yrwid/SM/smBoard.sch

## KiCad design smBoard.sch (2019-12-15)

Schematic: smBoard.sch

Parts:
10uF: C2
16Mhz: Crystal
100nF: C3
C1: 100nF
C4, C5: 22nF
C6: 47uF
C7: 10uF
D1, D2: LED
J1, J3, J4, J5: 01x04
J2: USB_B_Micro
LS1: Speaker
Q1: BD137; TO-126-3_Vertical
R1: 10k
R2, R3: 1k
R4: 5k
R5: 430
R6: 2k
SW1, SW2, SW3, SW4: SW_Push
U1: LD1117S33TR_SOT223; SOT-223-3_TabPin2
U2: ATmega328P-PU; DIP-28_W7.62mm
