yrwid/SM/koncowe_na_pokaz.ino

#include <stdlib.h>
#include "Talkie.h"             //glosnik
#include "PinChangeInterrupt.h" //przerwania
#include "DHT.h"
#include <SoftwareSerial.h>   //esp8266 - komunikacja pomiedzy esp a atmega
#define INTERRUPT_PIN_T 10    //przyciski
#define INTERRUPT_PIN_H 11
#define INTERRUPT_PIN_P 12
#define INTERRUPT_PIN_C 13
#define DHT11_PIN 6           //pin czujnika DHT
#include <Wire.h>             //do czujnika bmp180 - tylko do komunikacji I2C
#include <Adafruit_BMP085.h>  //do bmp180 - odczytywanie wartosci
SoftwareSerial esp8266(2, 4); //rx, tx pins - esp jako klient atmegi
DHT dht;                      //inicjalizacja
String GET;                   //zmienna do get request (http protocol)

Adafruit_BMP085 bmp;		  //inicjalizacja bmp

String NazwaSieci = "AndroidAP8607"; //Tu podaj nazwe swojej sieci.
String HasloSieci = "eaed34aec159"; //Tu hasło do sieci.


/* talkie obiekt - inicjalizacja */

Talkie voice(true, false); //true - korzystamy z pinu 3(pwm), false - nie korzystamy z pinu 11 (odwrócony pwm)
boolean tell_T = false, tell_H = false, tell_C = false, tell_P = false; //do funkcji przerwan

/* inicjalizacja wymaiwanych słów */

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
const uint8_t spMINUS[]    PROGMEM = {0xE6, 0x28, 0xC4, 0xF8, 0x44, 0x9A, 0xFB, 0xCD, 0xAD, 0x8D, 0x2A, 0x4E, 0x4A, 0xBC, 0xB8, 0x8C, 0xB9, 0x8A, 0xA9, 0x48, 0xED, 0x72, 0x87, 0xD3, 0x74, 0x3B, 0x1A, 0xA9, 0x9D, 0x6F, 0xB3, 0xCA, 0x5E, 0x8C, 0xC3, 0x7B, 0xF2, 0xCE, 0x5A, 0x5E, 0x35, 0x66, 0x5A, 0x3A, 0xAE, 0x55, 0xEB, 0x9A, 0x57, 0x75, 0xA9, 0x29, 0x6B, 0xEE, 0xB6, 0xD5, 0x4D, 0x37, 0xEF, 0xB5, 0x5D, 0xC5, 0x95, 0x84, 0xE5, 0xA6, 0xFC, 0x30, 0xE0, 0x97, 0x0C, 0x0D, 0x58, 0x40, 0x03, 0x1C, 0xA0, 0xC0, 0xFF, 0x03};

/* liczba z przedzialu <-9999 , 9999> */
void sayNumber(long n) 
{
  if (n<0) 
  {
      voice.say(spMINUS);
      sayNumber(-n);
  } 
  else if (n==0) 
  {
      voice.say(spZERO);
  } 
  else 
  {
        if (n>=1000) 
        {
            int thousands = n / 1000;
            sayNumber(thousands);
            voice.say(spTHOUSAND);
            n %= 1000;
            if ((n > 0) && (n<100)) voice.say(spAND);
        }
       
        if (n>=100) 
        {
            int hundreds = n / 100;
            sayNumber(hundreds);
            voice.say(spHUNDRED);
            n %= 100;
          
            if (n > 0) voice.say(spAND);
        }
       
        if (n>19) 
        {
            int tens = n / 10;
            switch (tens) 
            {
                case 2: voice.say(spTWENTY);                    break;
                case 3: voice.say(spTHIR_);  voice.say(spT);    break;
                case 4: voice.say(spFOUR);   voice.say(spT);    break;
                case 5: voice.say(spFIF_);   voice.say(spT);    break;
                case 6: voice.say(spSIX);    voice.say(spT);    break;
                case 7: voice.say(spSEVEN);  voice.say(spT);    break;
                case 8: voice.say(spEIGHT);  voice.say(spT);    break;
                case 9: voice.say(spNINE);   voice.say(spT);    break;
            }
         
            n %= 10;
        }

        switch(n)  
        {
            case 1: voice.say(spONE);                           break;
            case 2: voice.say(spTWO);                           break;
            case 3: voice.say(spTHREE);                         break;
            case 4: voice.say(spFOUR);                          break;
            case 5: voice.say(spFIVE);                          break;
            case 6: voice.say(spSIX);                           break;
            case 7: voice.say(spSEVEN);                         break;
            case 8: voice.say(spEIGHT);                         break;
            case 9: voice.say(spNINE);                          break;
            case 10: voice.say(spTEN);                          break;
            case 11: voice.say(spELEVEN);                       break;
            case 12: voice.say(spTWELVE);                       break;
            case 13: voice.say(spTHIR_);  voice.say(sp_TEEN);   break;
            case 14: voice.say(spFOUR);   voice.say(sp_TEEN);   break;
            case 15: voice.say(spFIF_);   voice.say(sp_TEEN);   break;
            case 16: voice.say(spSIX);    voice.say(sp_TEEN);   break;
            case 17: voice.say(spSEVEN);  voice.say(sp_TEEN);   break;
            case 18: voice.say(spEIGHT);  voice.say(sp_TEEN);   break;
            case 19: voice.say(spNINE);   voice.say(sp_TEEN);   break;
        }
  }
}
void interruptRoutine_T() {
  digitalWrite(8, HIGH);  //Zapalamy diode
  tell_T = true;          //ustawienie flagi
}
void interruptRoutine_H() {
  digitalWrite(8, HIGH);
  tell_H = true;
}
void interruptRoutine_P() {
  digitalWrite(8, HIGH);
  tell_P = true;
}
void interruptRoutine_C() {
  digitalWrite(8, HIGH);
  tell_C = true;
}

 
void setup()
{
   /*---------- zmienne do czujnika MQ-7 -----------*/
 float RS_gas = 0;
 float ratio = 0;
 float sensorValue = 0;
 float sensor_volt = 0;
 float R0 = 7000.0;   //wartosc rezystancji odczytana po "kalibracji"
/*---------- Do wywolywania wysylu dancyh z odpowidnim interwalem - millis() ----------*/
unsigned long aktualnyCzas = 0;   
unsigned long zapamietanyCzas_D = 0;//czas - dht11
unsigned long zapamietanyCzas_B = 0;//czas - bmp
unsigned long zapamietanyCzas_M = 0;//czas - mq7
int temperatura = 0;
int wilgotnosc = 0;
float temperature_p = 0, humidity_p = 0, pressure_p = 0, ppm=0;
String wilgotnosc_str, temperatura_str,temperatura2_str, cisnienie_str, ppm_str;
    esp8266.begin(115200);          //komunikacja esp - arduino bound rate
    esp8266.println("AT+CIPMUX=1"); //ustawienie trybu wielu polaczen
    delay(200);
    connect_c();                    //polaczenie z dana siecia wifi
    dht.setup(DHT11_PIN);           //iniciajliacja dht
    bmp.begin();                    //inicjalizacja bmp
  pinMode(INTERRUPT_PIN_T, INPUT_PULLUP); //inicjalizacja przyciskow
  pinMode(INTERRUPT_PIN_H, INPUT_PULLUP);
  pinMode(INTERRUPT_PIN_P, INPUT_PULLUP);
  pinMode(INTERRUPT_PIN_C, INPUT_PULLUP);
  pinMode(8, OUTPUT);               //inicjalizacja diody
  attachPinChangeInterrupt(digitalPinToPinChangeInterrupt(INTERRUPT_PIN_T), interruptRoutine_T, FALLING); //inicjalizacja przerwan
  attachPinChangeInterrupt(digitalPinToPinChangeInterrupt(INTERRUPT_PIN_H), interruptRoutine_H, FALLING);
  attachPinChangeInterrupt(digitalPinToPinChangeInterrupt(INTERRUPT_PIN_P), interruptRoutine_P, FALLING);
  attachPinChangeInterrupt(digitalPinToPinChangeInterrupt(INTERRUPT_PIN_C), interruptRoutine_C, FALLING);


}

void loop(){
   aktualnyCzas = millis(); //sczytujemy aktualny czas
   /* ----------- Odczytanie wartosci z czujnikow ------------- */
  if((int)dht.getHumidity()!=0)           //czujnik dht jak sczytuje bledne wartosci wystawia 0 - zastosowano bo jego zakres to 5-95% wiec bezpieczne
    humidity_p = dht.getHumidity();       //odczytanie wilgotnosci
  if((int)dht.getTemperature()!=0)           //czujnik dht jak sczytuje bledne wartosci wystawia 0
    temperatura_str =(String)dht.getTemperature();       //odczytanie tempeartury - tylko do wysylu
  temperature_p = bmp.readTemperature();  //odczytanie temperatury
  pressure_p = (bmp.readPressure()/100);  //odczytanie temperatury + przeskalowanie na hPa
  sensorValue = analogRead(A0);           //odczytanie wartosci z mq-7 - wartosc analogowa
  sensor_volt = sensorValue/1024*5.0;     //przeskalowanie na odpowiednie napiecie
  RS_gas = (5.0-sensor_volt)/sensor_volt; //odpowiednia proporcja
  ratio = RS_gas/R0;                      //na podstawie R0 z kalibracji
  ppm = pow(1538.46*ratio, -1.709);           //na podstawie charakterystyki z dokumentacji
  

  /* -------------------------jezeli zostawy wywolane przerwania ------------------------------------ */
  if(tell_T == true){sayNumber((int)temperature_p);  tell_T = false;digitalWrite(8, LOW);} //jezeli zostalo wywolane przerwanie - sayNumber(), wyzeruj flage, zgas diode
  if(tell_H == true){sayNumber((int)humidity_p);  tell_H = false;digitalWrite(8, LOW);}
  if(tell_P == true){sayNumber((int)pressure_p);  tell_P = false;digitalWrite(8, LOW);}
  if(tell_C == true){sayNumber((int)ppm);  tell_C = false;digitalWrite(8, LOW);}
  
  /* -------------------------- wysylanie danych ---------------------------------------------------- */
  //Jeśli minela ponad minuta - wyslij dane
  if (aktualnyCzas-zapamietanyCzas_D >= 60000UL) {
    zapamietanyCzas_D = aktualnyCzas;//Zapamietaj aktualny czas
 //Skalowanie wartosci na string
  wilgotnosc_str = (String)humidity_p;
  updateDHT(temperatura_str, wilgotnosc_str); //wysylam dane
  }
  if (aktualnyCzas-zapamietanyCzas_B >= 61000UL) {
    zapamietanyCzas_B = aktualnyCzas;
  temperatura2_str = (String)temperature_p;
  cisnienie_str = (String)pressure_p;
      updateBMP(temperatura2_str, cisnienie_str);
  }
  if (aktualnyCzas-zapamietanyCzas_M >= 62000UL) {
    //Zapamietaj aktualny czas
    zapamietanyCzas_M = aktualnyCzas;
    ppm_str = (String)ppm;
      updateMQ(ppm_str);
  }
}

void updateDHT(String a, String b){
  delay(200);
  GET = "GET /dht.php?temperature="+a+"&humidity="+b+" HTTP/1.1"; //tworzenie get requesta
  String command = GET;
 command += "\r\n";
 command += "Host: 192.168.43.85"; //ip komputera na ktorym jest serwer
 command += "\r\n\r\n";
  esp8266.println("AT+CIPSTART=4,\"TCP\",\"192.168.43.85\",80"); //192.168.43.85 //rozpoczecie komunikacji z serwerem
  delay(500);//bylo 5000
  esp8266.print("AT+CIPSEND=4,");//wysylanie 4 kanal, dlugosc wiadomosci
  esp8266.println(command.length());  
  delay(300);
  esp8266.print(command); //wyslanie komendy
  delay(300);//bylo 3000
  esp8266.println("AT+CIPCLOSE=4");//zamykamy polaczenie
}
void updateBMP(String a, String b){
  GET = "GET /bmp.php?temperature_bmp="+a+"&humidity_bmp="+b+" HTTP/1.1";
  String command = GET;
 command += "\r\n";
 command += "Host: 192.168.43.85";
 command += "\r\n\r\n";
  esp8266.println("AT+CIPSTART=4,\"TCP\",\"192.168.43.85\",80");
  delay(500);
  esp8266.print("AT+CIPSEND=4,");
  esp8266.println(command.length());  
  delay(300);
  esp8266.print(command);
  delay(300);
  esp8266.println("AT+CIPCLOSE=4");
}
void updateMQ(String a){
  GET = "GET /mq.php?ppm="+a+" HTTP/1.1";
  String command = GET;
 command += "\r\n";
 command += "Host: 192.168.43.85";
 command += "\r\n\r\n";
  esp8266.println("AT+CIPSTART=4,\"TCP\",\"192.168.43.85\",80");
  delay(500);
  esp8266.print("AT+CIPSEND=4,");
  esp8266.println(command.length());  
  delay(300);
  esp8266.print(command);
  delay(300);
  esp8266.println("AT+CIPCLOSE=4");
}
void connect_c(){
  esp8266.println("AT+CWMODE=1"); //tryb pracy esp - klient
  delay(2000);
        String cmd = "AT+CWJAP=\""+NazwaSieci+"\", \""+HasloSieci+"\""; //polaczenie z siecia
        delay(200);
  esp8266.println(cmd);
  delay(2000);
}
