yrwid/SM/s_owa/numbers.h

typedef unsigned char uint8_t;

const uint8_t spZERO[] PROGMEM = {0x69,0xFB,0x59,0xDD,0x51,0xD5,0xD7,0xB5,0x6F,0x0A,0x78,0xC0,0x52,0x01,0x0F,0x50,0xAC,0xF6,0xA8,0x16,0x15,0xF2,0x7B,0xEA,0x19,0x47,0xD0,0x64,0xEB,0xAD,0x76,0xB5,0xEB,0xD1,0x96,0x24,0x6E,0x62,0x6D,0x5B,0x1F,0x0A,0xA7,0xB9,0xC5,0xAB,0xFD,0x1A,0x62,0xF0,0xF0,0xE2,0x6C,0x73,0x1C,0x73,0x52,0x1D,0x19,0x94,0x6F,0xCE,0x7D,0xED,0x6B,0xD9,0x82,0xDC,0x48,0xC7,0x2E,0x71,0x8B,0xBB,0xDF,0xFF,0x1F};
const uint8_t spONE[] PROGMEM = {0x66,0x4E,0xA8,0x7A,0x8D,0xED,0xC4,0xB5,0xCD,0x89,0xD4,0xBC,0xA2,0xDB,0xD1,0x27,0xBE,0x33,0x4C,0xD9,0x4F,0x9B,0x4D,0x57,0x8A,0x76,0xBE,0xF5,0xA9,0xAA,0x2E,0x4F,0xD5,0xCD,0xB7,0xD9,0x43,0x5B,0x87,0x13,0x4C,0x0D,0xA7,0x75,0xAB,0x7B,0x3E,0xE3,0x19,0x6F,0x7F,0xA7,0xA7,0xF9,0xD0,0x30,0x5B,0x1D,0x9E,0x9A,0x34,0x44,0xBC,0xB6,0x7D,0xFE,0x1F};
const uint8_t spTWO[]  PROGMEM = {0x06,0xB8,0x59,0x34,0x00,0x27,0xD6,0x38,0x60,0x58,0xD3,0x91,0x55,0x2D,0xAA,0x65,0x9D,0x4F,0xD1,0xB8,0x39,0x17,0x67,0xBF,0xC5,0xAE,0x5A,0x1D,0xB5,0x7A,0x06,0xF6,0xA9,0x7D,0x9D,0xD2,0x6C,0x55,0xA5,0x26,0x75,0xC9,0x9B,0xDF,0xFC,0x6E,0x0E,0x63,0x3A,0x34,0x70,0xAF,0x3E,0xFF,0x1F};
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
const uint8_t spTHOUSAND[] PROGMEM = {0x08,0x48,0xCC,0x0C,0x01,0x5D,0xA9,0x21,0x60,0x2A,0x33,0x04,0x4C,0x65,0x4A,0x80,0xE9,0x52,0x57,0xDD,0x84,0x7B,0x98,0x36,0x3E,0x75,0x13,0x19,0xE1,0xB4,0xE5,0x54,0x55,0x76,0x86,0xCB,0x9A,0x53,0x15,0xDB,0x99,0xAA,0x6B,0x4E,0x51,0x42,0x67,0x8A,0x2E,0x39,0x59,0x0A,0x9D,0xA1,0xB6,0x64,0x64,0x31,0x4F,0xBA,0xDA,0x93,0x55,0x44,0xB7,0xE9,0x2A,0x9B,0x57,0x95,0xF9,0xBA,0xAB,0x74,0x69,0x75,0x62,0x13,0x2A,0xB2,0xB9,0xF5,0x87,0x8B,0x87,0x8B,0x36,0x07,0x3C,0x82,0x1E,0x81,0x32,0xFD,0xEE,0x1A,0xC6,0x52,0xD7,0x3A,0x49,0xBA,0x99,0x6C,0x39,0x7B,0xA7,0xE9,0x1A,0xB2,0xA5,0xED,0x43,0x55,0x88,0xE1,0x97,0xF2,0x74,0x59,0x21,0xC6,0xAF,0xCB,0x33,0x1C,0x99,0xBB,0xC5,0x2D,0xD7,0xB0,0x24,0xE1,0x1A,0x2F,0x9C,0xCD,0xA0,0x85,0xBB,0x5D,0x77,0x16,0x89,0xD1,0x26,0xC9,0xCC,0x95,0x04,0x65,0xBB,0x25,0x25,0xB7,0x11,0x96,0x25,0xBD,0x3A,0x7D,0x53,0xAB,0xB9,0x69,0x1B,0xF3,0x35,0x67,0xA6,0x2A,0x5B,0xFE,0x1F};
