yrwid/SM/(commit log)

2019-11-26 PCB layout
2019-12-15 added pcb schematics
    [smBoard.sch]
